realdengziqi/URGEPEAKLOGGER_AT32_-RTTHREAD/firmware/固件目录说明.md

# 固件目录说明

本目录存放参与固件构建的工程文件。

- `app`：应用入口和设备业务逻辑。
- `bsp/at32f403`：AT32F403ARGT7 板级支持和 RT-Thread 板级钩子。
- `cmake`：GCC/CMake 工具链文件和目标定义。
- `external_port`：第三方中间件的项目适配层。
- `linker`：GCC 链接脚本。
- `docs`：固件调试记录、硬件映射和设计说明。
- `vendor`：已复制到固件工程内并参与构建的第三方或厂商源码。

## 当前状态

- AT32F403A_407 官方固件库 V2.2.2 已从 `external` 复制到 `vendor`。
- 目标 MCU 已确认为 AT32F403ARGT7。
- RT-Thread 源码以 `external/rt-thread` 子模块形式跟踪，版本为 `v5.2.2`。
- RT-Thread v5.2.2 最小内核文件已复制到 `vendor/rt-thread-v5.2.2`，并已接入 GCC/CMake 构建。
- 当前硬件初始化覆盖已验证的调试串口、LED、按键、ST7789 SPI2 基础显示驱动、HDC1080 和 AT24C128C EEPROM。
- `drivers/sensor` 包含项目本地 HDC1080 I2C1 温湿度驱动。
- `drivers/storage` 包含项目本地 AT24C128C I2C2 EEPROM 驱动；参数持久化通过 FlashDB KVDB 使用这 16 KB EEPROM。
- `app_main` 当前处于后端优先模式。UI 自动初始化和 UI 按键轮询已暂停，使 COM12 串口测试优先聚焦后端数据访问。
- `app_data_service` 提供第一版后台数据服务线程和设备数据快照边界。当前线程名为 `data_svc`，优先级 18，栈 768 字节，更新周期 200 ms，并每 1000 ms 读取一次 HDC1080 环境温湿度。
- `app_param_service` 维护运行期参数表，执行范围校验，并通过 EEPROM KVDB 保存和加载参数镜像。
- `app_record_service` 提供运行期事件记录环形缓冲，当前容量 16 条，并将报警/普通事件与浪涌事件追加到片内 Flash TSDB。
- `app_ui` 保留为前端显示层，但在后端优先模式下不再自动启动。它只渲染 `data_service` 快照数据，不直接访问 ADC、Flash、Modbus 或硬件采样。
- `app_key_input` 扫描并消抖已验证的前面板按键，然后向 UI 层上报前端按键事件。
- `app_bringup` 封装 LED、按键和 LCD 的硬件 bring-up 命令，使 `app_main` 聚焦主循环和 CLI 分发。
- 当前主线只保留 GCC/CMake/J-Link CLI 构建和烧录路径。

## 调试文档

- `docs/硬件引脚映射.md`：已验证的调试串口、LED、按键和当前 ST7789 SPI2 屏幕路径 GPIO 映射。
- `docs/后端串口测试说明.md`：后端优先阶段的数据、参数、记录和 RTC 串口测试流程。
- `docs/命令行工具链迁移说明.md`：CMake/GCC/J-Link CLI 构建和烧录流程。
- `docs/后端数据架构规划.md`：数据后端、缓存、请求队列和 Modbus 响应及时性规划。
- `docs/罗氏线圈参数确认清单.md`：罗氏线圈参数、竞品信息和待确认项。
- `docs/罗氏线圈工作原理和测量方法.md`：罗氏线圈原理、高速 ADC 采样和数字积分测量路线。
- `docs/浪涌输入运放前端工作逻辑分析.md`：主控板浪涌输入运放前端拓扑和工作逻辑。
- `docs/调试命令说明.md`：当前 MSH/串口调试命令说明。
- `docs/图形界面集成计划.md`：uGUI/显示相关集成计划。
