realdengziqi/URGEPEAKLOGGER_AT32_-RTTHREAD/firmware/docs/后端数据架构规划.md

# 数据后端架构计划

本文记录当前后端优先开发方向。项目按工业仪表固件处理，UI、Modbus RTU、Modbus TCP、MSH 调试命令都属于前端；采样、参数、记录、报警和时间状态由后端服务统一维护。

## 分层边界

```text
硬件采集层
  ADC / NTC / HDC1080 / DI / RTC / RS485 / Ethernet / Flash-EEPROM
  ↓
后台服务层
  data_service / backend_request / param_service / record_service / alarm_service
  ↓
前端适配层
  UI / Modbus RTU / Modbus TCP / MSH / 后续 Web 配置
```

前端读取数据时只读 `data_service_get_snapshot()` 或专用查询接口；前端修改状态时提交 `backend_request`，不得直接写 Flash、记录区、报警状态或共享业务结构体。

非浪涌报警按 `非浪涌报警架构设计.md` 处理：活跃报警由 `alarm_service` 维护，计划用 EEPROM KVDB 保存未闭合报警恢复镜像；历史报警改为事件日志，`alarm_start` 和 `alarm_clear` 都由 `record_service` 追加写入片内 Flash TSDB，不在查询路径合并闭合记录。

## 线程计划

当前阶段保留少量线程，先把边界做稳：

| 线程 | 优先级 | 栈 | 职责 |
| --- | --- | --- | --- |
| `mb_rtu` | 16 | 1024 | FreeModbus RTU poll，只做协议收发和寄存器回调 |
| `backend_req` | 17 | 1536 | 串行处理前端写请求，例如设置参数、保存参数、清记录 |
| `data_svc` | 18 | 1024 | 维护统一数据快照，读取 RTC/低速传感器，融合参数状态和非浪涌报警状态 |
| `record_wr` | 20 | 1024 | 从消息队列消费记录持久化请求，异步追加 FlashDB TSDB |
| `tshell` | 20 | 2048 | 开发调试命令 |
| `main` | 10 | 2048 | 当前保留 bring-up poll，后续逐步减少业务职责 |

2026-06-23 串口实测线程状态：

| 线程 | 优先级 | 状态 | 栈使用 | 说明 |
| --- | --- | --- | --- | --- |
| `tshell` | 20 | `run` | 612/2048 | 正在执行 MSH 命令时为运行态，正常 |
| `mb_rtu` | 16 | `suspend` | 360/1024 | 等待 FreeModbus 事件，正常 |
| `backend_req` | 17 | `suspend` | 412/1024 | 等待前端请求队列，正常 |
| `record_wr` | 20 | `suspend` | 376/1024 | 等待记录写入队列，正常 |
| `data_svc` | 18 | `suspend` | 468/768 | 等待周期 tick，后续增加逻辑时建议改到 1024 |
| `tidle0` | 31 | `ready` | 104/512 | 空闲线程 |
| `timer` | 4 | `suspend` | 156/512 | RT-Thread 软件定时器线程 |
| `main` | 10 | `suspend` | 1100/2048 | 初始化完成后挂起，正常 |

后续接入高速采样、网络和 UI 后，再增加：

| 线程 | 建议优先级 | 职责 |
| --- | --- | --- |
| `adc_sample` | 12-14 | 采样调度、浪涌检测事件上报 |
| `modbus_tcp` | 16-17 | TCP 前端，共用 `modbus_map` |
| `ui` | 22 | LCD 页面刷新和按键事件消费 |

## 缓存机制

短期继续使用 `device_data_snapshot_t` 作为统一快照。快照由 `data_service` 写入，UI/Modbus/MSH 只读。

当前实现用短临界区复制快照，字段继续增加后建议切换到双缓冲：

```text
data_service 写 back buffer
更新 version/sequence
切换 active buffer
前端读取 active buffer
```

快照建议拆分语义，但对外可以继续合并输出：

```text
realtime      浪涌峰值、NTC、温湿度、DI
status        time_valid、sensor_valid、alarm、rs485、tcp
param_status  参数版本、dirty、持久化状态
diag          update_count、通信计数、错误计数
```

## 请求机制

`backend_request` 是前端写操作的统一入口。当前最小版本支持：

- 设置运行期参数
- 保存参数到 AT24C128 EEPROM KVDB
- 从 AT24C128 重新加载参数
- 恢复运行期默认参数
- 清除运行期记录

后续扩展：

- 设置 RTC 时间
- 清除报警
- 查询/删除历史记录
- 恢复出厂设置
- 网络参数变更后重启协议栈

原则：Modbus 回调和 UI 事件只提交请求并等待结果，不直接做持久化慢操作。

## Modbus 响应及时性规范

Modbus RTU 是强时序前端，寄存器回调必须尽快返回。后续所有 Modbus 相关开发遵守以下规则：

- Modbus 读寄存器只读取 RAM 快照、RAM 参数表或 RAM 状态计数，不允许触发 I2C、ADC 阻塞采样、EEPROM、Flash、网络重启等慢操作。
- Modbus 写普通运行参数只更新 RAM shadow，必须是有界快速操作。
- Modbus 写保存参数、清除记录、恢复默认、设置时间、网络重启等慢操作时，只投递异步请求并快速返回；实际完成状态通过状态寄存器查询。
- EEPROM/Flash 写入不得发生在 Modbus 回调路径内。
- 传感器采样不得发生在 Modbus 回调路径内；Modbus 只能读取 `data_service` 已缓存的快照。
- 如果某个操作最坏情况无法在数毫秒内完成，不得作为同步 Modbus 写回调执行。

当前代码约定：

- `backend_request_set_param_async()` / `backend_request_set_params_async()`：用于 Modbus 等强时序前端，只做参数校验和非阻塞入队；实际 RAM 参数更新由 `backend_req` 线程执行。
- `backend_request_*()` 同步接口：用于 MSH、UI 或显式慢操作请求；EEPROM/Flash 等慢操作仍不得发生在 Modbus 回调路径内。

## Modbus 映射

Modbus RTU 和后续 Modbus TCP 必须共用同一份寄存器映射。当前使用：

```text
app_modbus_rtu.c   协议线程、eMBInit/eMBPoll
app_modbus_map.c   holding/input/coils/discrete 映射
```

正式寄存器表冻结前，当前 holding/input 映射只作为 bring-up 和后端验证使用。

## 下一阶段验收

1. GCC/CMake 构建通过。
2. COM12 启动日志出现 `backend_req`、`data_svc`、`mb_rtu`。
3. MSH `param set/save/load/defaults` 通过 `backend_request` 正常工作。
4. COM16 Modbus 读 holding/input 正常，写 holding 参数后能读回。
5. `sys threads` 显示线程栈余量合理。
6. 记录追加不在 Modbus 回调路径内写 Flash，TSDB 写入由 `record_wr` 异步完成。
7. Modbus 并发读写和记录注入期间无 timeout，响应时间无明显长尾。

## 已确认硬件映射

- TI1..TI5 业务输入：底层对应 `DI0..DI4` / bit0..bit4，MCU 引脚为 `PA7 / PA6 / PA5 / PA4 / PA3`。业务默认 open 触发报警；当前已确认 open 为 MCU 低电平，close 为 MCU 高电平。
- PC0 / ADC1_IN10：NTC 输入，用户于 2026-06-22 确认。
- PC1 / ADC2_IN11：浪涌输入，用户于 2026-06-22 确认。
