realdengziqi/URGEPEAKLOGGER_AT32_-RTTHREAD/firmware/external_port/freemodbus_port/mbconfig.h

#ifndef MB_CONFIG_H
#define MB_CONFIG_H

#define MB_MASTER_ASCII_ENABLED                 (0)
#define MB_MASTER_RTU_ENABLED                   (0)
#define MB_MASTER_TCP_ENABLED                   (0)

#define MB_SLAVE_ASCII_ENABLED                  (0)
#define MB_SLAVE_RTU_ENABLED                    (1)
#define MB_SLAVE_TCP_ENABLED                    (0)

#define MB_ASCII_TIMEOUT_SEC                    (1)
#define MB_FUNC_HANDLERS_MAX                    (16)
#define MB_FUNC_OTHER_REP_SLAVEID_BUF           (32)
#define MB_FUNC_OTHER_REP_SLAVEID_ENABLED       (1)

#define MB_FUNC_READ_INPUT_ENABLED              (1)
#define MB_FUNC_READ_HOLDING_ENABLED            (1)
#define MB_FUNC_WRITE_HOLDING_ENABLED           (1)
#define MB_FUNC_WRITE_MULTIPLE_HOLDING_ENABLED  (1)
#define MB_FUNC_READ_COILS_ENABLED              (0)
#define MB_FUNC_WRITE_COIL_ENABLED              (0)
#define MB_FUNC_WRITE_MULTIPLE_COILS_ENABLED    (0)
#define MB_FUNC_READ_DISCRETE_INPUTS_ENABLED    (0)
#define MB_FUNC_READWRITE_HOLDING_ENABLED       (0)

#endif
