realdengziqi/URGEPEAKLOGGER_AT32_-RTTHREAD/firmware/bsp/at32f403/inc/rtconfig.h

#ifndef RT_CONFIG_H
#define RT_CONFIG_H

#define RT_NAME_MAX                     16
#define RT_ALIGN_SIZE                   4
#define RT_THREAD_PRIORITY_MAX          32
#define RT_TICK_PER_SECOND              1000
#define RT_CPUS_NR                      1

#define RT_USING_OVERFLOW_CHECK
#define RT_USING_HOOK

#define IDLE_THREAD_STACK_SIZE          512
#define RT_TIMER_THREAD_STACK_SIZE      512
#define RT_TIMER_THREAD_PRIO            4

#define RT_USING_TIMER_SOFT
#define RT_USING_SEMAPHORE
#define RT_USING_MUTEX
#define RT_USING_EVENT
#define RT_USING_MAILBOX
#define RT_USING_MESSAGEQUEUE

#define RT_USING_HEAP
#define RT_USING_SMALL_MEM
#define RT_USING_SMALL_MEM_AS_HEAP
#define RT_USING_CONSOLE
#define RT_CONSOLEBUF_SIZE              128
#define RT_BACKTRACE_LEVEL_MAX_NR       32

#define RT_USING_MSH
#define RT_USING_FINSH
#define FINSH_USING_MSH
#define FINSH_USING_SYMTAB
#define FINSH_USING_DESCRIPTION
#define FINSH_THREAD_NAME               "tshell"
#define FINSH_THREAD_PRIORITY           20
#define FINSH_THREAD_STACK_SIZE         2048
#define FINSH_CMD_SIZE                  96
#define FINSH_ARG_MAX                   8

#define RT_USING_USER_MAIN
#define RT_MAIN_THREAD_STACK_SIZE       2048
#define RT_MAIN_THREAD_PRIORITY         10

#endif
