realdengziqi/URGEPEAKLOGGER_AT32_-RTTHREAD/firmware/external_port/surge_ui_kit/surge_ui_widgets.c

#include "surge_ui_widgets.h"

#include "surge_ui_font_zh_18.h"
#include "surge_ui_font_zh_20.h"
#include "surge_ui_font_zh_24.h"
#include "ugui_port.h"

typedef struct
{
    rt_uint8_t width;
    rt_uint8_t height;
    rt_uint8_t bytes_per_row;
    rt_uint8_t bits_per_pixel;
    const surge_ui_zh_glyph_t *glyphs;
    rt_uint16_t glyph_count;
} surge_ui_zh_font_t;

static const surge_ui_zh_font_t surge_ui_zh_font_18 =
{
    SURGE_UI_ZH_18_FONT_W,
    SURGE_UI_ZH_18_FONT_H,
    SURGE_UI_ZH_18_FONT_BYTES_PER_ROW,
    SURGE_UI_ZH_18_FONT_BITS_PER_PIXEL,
    surge_ui_zh_18_glyphs,
    SURGE_UI_ZH_18_GLYPH_COUNT
};

static const surge_ui_zh_font_t surge_ui_zh_font_20 =
{
    SURGE_UI_ZH_20_FONT_W,
    SURGE_UI_ZH_20_FONT_H,
    SURGE_UI_ZH_20_FONT_BYTES_PER_ROW,
    SURGE_UI_ZH_20_FONT_BITS_PER_PIXEL,
    surge_ui_zh_20_glyphs,
    SURGE_UI_ZH_20_GLYPH_COUNT
};

static const surge_ui_zh_font_t surge_ui_zh_font_24 =
{
    SURGE_UI_ZH_24_FONT_W,
    SURGE_UI_ZH_24_FONT_H,
    SURGE_UI_ZH_24_FONT_BYTES_PER_ROW,
    SURGE_UI_ZH_24_FONT_BITS_PER_PIXEL,
    surge_ui_zh_24_glyphs,
    SURGE_UI_ZH_24_GLYPH_COUNT
};

static const surge_ui_text_style_t surge_ui_default_text_8 =
{
    SURGE_UI_ZH_SIZE_18,
    &FONT_8X12
};

#if SURGE_UI_USE_HEADER
static const surge_ui_header_style_t surge_ui_default_header_style =
{
    { SURGE_UI_ZH_SIZE_18, &FONT_12X20 },
    { SURGE_UI_ZH_SIZE_18, &FONT_8X12 },
    8,
    7,
    182,
    10
};
#endif

#if SURGE_UI_USE_NAV_HEADER
static const surge_ui_nav_header_style_t surge_ui_default_nav_header_style =
{
    { SURGE_UI_ZH_SIZE_18, &FONT_8X12 },
    { SURGE_UI_ZH_SIZE_18, &FONT_12X20 },
    { SURGE_UI_ZH_SIZE_18, &FONT_8X12 },
    8,
    10,
    48,
    7,
    182,
    10
};
#endif

#if SURGE_UI_USE_FOOTER
static const surge_ui_footer_style_t surge_ui_default_footer_style =
{
    { SURGE_UI_ZH_SIZE_18, &FONT_8X12 },
    8,
    226
};
#endif

#if SURGE_UI_USE_SECTION_TITLE
static const surge_ui_section_title_style_t surge_ui_default_section_title_style =
{
    { SURGE_UI_ZH_SIZE_18, &FONT_8X12 },
    22,
    4,
    14,
    4,
    12,
    4,
    8,
    13
};
#endif

#if SURGE_UI_USE_EMPTY_STATE
static const surge_ui_empty_state_style_t surge_ui_default_empty_state_style =
{
    { SURGE_UI_ZH_SIZE_20, &FONT_12X20 },
    { SURGE_UI_ZH_SIZE_18, &FONT_8X12 },
    96,
    24,
    5,
    44,
    72
};
#endif

#if SURGE_UI_USE_LOADING_STATE
static const surge_ui_loading_state_style_t surge_ui_default_loading_state_style =
{
    { SURGE_UI_ZH_SIZE_20, &FONT_12X20 },
    { SURGE_UI_ZH_SIZE_18, &FONT_8X12 },
    96,
    25,
    4,
    14,
    44,
    72
};
#endif

#if SURGE_UI_USE_TOAST
static const surge_ui_toast_style_t surge_ui_default_toast_style =
{
    { SURGE_UI_ZH_SIZE_18, &FONT_10X16 },
    34,
    8,
    5
};
#endif

#if SURGE_UI_USE_PAGE_INDICATOR
static const surge_ui_page_indicator_style_t surge_ui_default_page_indicator_style =
{
    18,
    8,
    3,
    8
};
#endif

#if SURGE_UI_USE_ACTION_BAR
static const surge_ui_action_bar_style_t surge_ui_default_action_bar_style =
{
    { SURGE_UI_ZH_SIZE_18, &FONT_10X16 },
    34,
    0,
    10,
    8
};
#endif

#if SURGE_UI_USE_SAVE_STATUS_CHIP
static const surge_ui_save_status_chip_style_t surge_ui_default_save_status_chip_style =
{
    { SURGE_UI_ZH_SIZE_18, &FONT_8X12 },
    22,
    8,
    10,
    11,
    3,
    5
};
#endif

#if SURGE_UI_USE_COMPACT_VALUE_TILE
static const surge_ui_compact_value_tile_style_t surge_ui_default_compact_value_tile_style =
{
    { SURGE_UI_ZH_SIZE_18, &FONT_8X12 },
    { SURGE_UI_ZH_SIZE_18, &FONT_10X16 },
    { SURGE_UI_ZH_SIZE_18, &FONT_8X12 },
    56,
    6,
    25,
    42,
    2,
    3
};
#endif

#if SURGE_UI_USE_COMPACT_STATUS_TILE
static const surge_ui_compact_status_tile_style_t surge_ui_default_compact_status_tile_style =
{
    { SURGE_UI_ZH_SIZE_18, &FONT_8X12 },
    { SURGE_UI_ZH_SIZE_18, &FONT_12X20 },
    54,
    7,
    28,
    2
};
#endif

#if SURGE_UI_USE_SWITCH
static const surge_ui_switch_style_t surge_ui_default_switch_style =
{
    { SURGE_UI_ZH_SIZE_18, &FONT_10X16 },
    32,
    8
};
#endif

#if SURGE_UI_USE_STEPPER
static const surge_ui_stepper_style_t surge_ui_default_stepper_style =
{
    { SURGE_UI_ZH_SIZE_18, &FONT_8X12 },
    { SURGE_UI_ZH_SIZE_18, &FONT_10X16 },
    { SURGE_UI_ZH_SIZE_18, &FONT_8X12 },
    { SURGE_UI_ZH_SIZE_18, &FONT_10X16 },
    46,
    10,
    7,
    20,
    22,
    26,
    24,
    11,
    62,
    4
};
#endif

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
};
#endif

#if SURGE_UI_USE_DETAIL_VALUE
static const surge_ui_detail_value_style_t surge_ui_default_detail_value_style =
{
    { SURGE_UI_ZH_SIZE_18, &FONT_10X16 },
    { SURGE_UI_ZH_SIZE_18, &FONT_16X26 },
    { SURGE_UI_ZH_SIZE_18, &FONT_10X16 },
    82,
    10,
    36,
    44,
    6
};
#endif

#if SURGE_UI_USE_DETAIL_FIELD_ROW
static const surge_ui_detail_field_row_style_t surge_ui_default_detail_field_row_style =
{
    { SURGE_UI_ZH_SIZE_18, &FONT_8X12 },
    { SURGE_UI_ZH_SIZE_18, &FONT_8X12 },
    28,
    10,
    8,
    10,
    8
};
#endif

#if SURGE_UI_USE_CONFIRM_DIALOG
static const surge_ui_confirm_dialog_style_t surge_ui_default_confirm_dialog_style =
{
    { SURGE_UI_ZH_SIZE_20, &FONT_12X20 },
    { SURGE_UI_ZH_SIZE_18, &FONT_10X16 },
    { SURGE_UI_ZH_SIZE_18, &FONT_10X16 },
    118,
    14,
    48,
    78,
    12,
    30,
    16
};
#endif

static UG_COLOR surge_ui_status_color(surge_ui_status_t status)
{
    if (status == SURGE_UI_STATUS_ALARM)
    {
        return SURGE_UI_COLOR_ALARM;
    }

    if (status == SURGE_UI_STATUS_WARN)
    {
        return SURGE_UI_COLOR_WARN;
    }

    return SURGE_UI_COLOR_OK;
}

#if SURGE_UI_USE_ACTION_BAR || SURGE_UI_USE_CONFIRM_DIALOG
static UG_COLOR surge_ui_status_text_color(surge_ui_status_t status)
{
    if (status == SURGE_UI_STATUS_ALARM)
    {
        return SURGE_UI_COLOR_TEXT;
    }

    return SURGE_UI_COLOR_BG;
}
#endif

static const rt_uint8_t *surge_ui_find_zh_glyph(const surge_ui_zh_font_t *zh_font, rt_uint16_t codepoint)
{
    rt_uint16_t i;

    for (i = 0U; i < zh_font->glyph_count; i++)
    {
        if (zh_font->glyphs[i].codepoint == codepoint)
        {
            return zh_font->glyphs[i].bitmap;
        }
    }

    return RT_NULL;
}

static const surge_ui_zh_font_t *surge_ui_get_zh_font(surge_ui_zh_size_t size)
{
    if (size == SURGE_UI_ZH_SIZE_24)
    {
        return &surge_ui_zh_font_24;
    }

    if (size == SURGE_UI_ZH_SIZE_20)
    {
        return &surge_ui_zh_font_20;
    }

    return &surge_ui_zh_font_18;
}

#if SURGE_UI_USE_SECTION_TITLE || SURGE_UI_USE_EMPTY_STATE || SURGE_UI_USE_LOADING_STATE || SURGE_UI_USE_TOAST || SURGE_UI_USE_ACTION_BAR || SURGE_UI_USE_SAVE_STATUS_CHIP || SURGE_UI_USE_COMPACT_VALUE_TILE || SURGE_UI_USE_COMPACT_STATUS_TILE || SURGE_UI_USE_SWITCH || SURGE_UI_USE_STEPPER || SURGE_UI_USE_RECORD_ROW || SURGE_UI_USE_DETAIL_VALUE || SURGE_UI_USE_DETAIL_FIELD_ROW || SURGE_UI_USE_CONFIRM_DIALOG
static rt_int16_t surge_ui_text_width(const char *text, const surge_ui_text_style_t *style)
{
    const surge_ui_text_style_t *resolved;
    const surge_ui_zh_font_t *zh_font;
    const UG_FONT *ascii_font;
    const unsigned char *p;
    rt_int16_t width;

    if (text == RT_NULL)
    {
        return 0;
    }

    resolved = (style != RT_NULL) ? style : &surge_ui_default_text_8;
    zh_font = surge_ui_get_zh_font(resolved->zh_size);
    ascii_font = (resolved->ascii_font != RT_NULL) ? resolved->ascii_font : &FONT_8X12;
    p = (const unsigned char *)text;
    width = 0;

    while (*p != '\0')
    {
        if (*p < 0x80U)
        {
            width = (rt_int16_t)(width + ascii_font->char_width);
            p++;
            continue;
        }

        if (((p[0] & 0xF0U) == 0xE0U) && ((p[1] & 0xC0U) == 0x80U) && ((p[2] & 0xC0U) == 0x80U))
        {
            width = (rt_int16_t)(width + zh_font->width);
            p = (const unsigned char *)(p + 3);
        }
        else
        {
            width = (rt_int16_t)(width + zh_font->width);
            p++;
        }
    }

    return width;
}
#endif

#if SURGE_UI_USE_EMPTY_STATE || SURGE_UI_USE_LOADING_STATE || SURGE_UI_USE_TOAST || SURGE_UI_USE_ACTION_BAR || SURGE_UI_USE_SAVE_STATUS_CHIP || SURGE_UI_USE_COMPACT_VALUE_TILE || SURGE_UI_USE_COMPACT_STATUS_TILE || SURGE_UI_USE_SWITCH || SURGE_UI_USE_STEPPER || SURGE_UI_USE_DETAIL_VALUE || SURGE_UI_USE_CONFIRM_DIALOG
static void surge_ui_draw_centered_text(rt_int16_t x,
                                        rt_int16_t y,
                                        rt_int16_t w,
                                        const char *text,
                                        UG_COLOR fg,
                                        UG_COLOR bg,
                                        const surge_ui_text_style_t *style)
{
    rt_int16_t text_w;
    rt_int16_t text_x;

    text_w = surge_ui_text_width(text, style);
    text_x = x;
    if (text_w < w)
    {
        text_x = (rt_int16_t)(x + ((w - text_w) / 2));
    }

    surge_ui_draw_text(text_x, y, text, fg, bg, style);
}
#endif

static UG_COLOR surge_ui_blend_rgb565(UG_COLOR fg, UG_COLOR bg, rt_uint8_t level)
{
    rt_uint16_t fr;
    rt_uint16_t fg6;
    rt_uint16_t fb;
    rt_uint16_t br;
    rt_uint16_t bg6;
    rt_uint16_t bb;
    rt_uint16_t r;
    rt_uint16_t g;
    rt_uint16_t b;

    if (level == 0U)
    {
        return bg;
    }
    if (level >= 15U)
    {
        return fg;
    }

    fr = (rt_uint16_t)((fg >> 11) & 0x1FU);
    fg6 = (rt_uint16_t)((fg >> 5) & 0x3FU);
    fb = (rt_uint16_t)(fg & 0x1FU);
    br = (rt_uint16_t)((bg >> 11) & 0x1FU);
    bg6 = (rt_uint16_t)((bg >> 5) & 0x3FU);
    bb = (rt_uint16_t)(bg & 0x1FU);

    r = (rt_uint16_t)(((fr * level) + (br * (15U - level)) + 7U) / 15U);
    g = (rt_uint16_t)(((fg6 * level) + (bg6 * (15U - level)) + 7U) / 15U);
    b = (rt_uint16_t)(((fb * level) + (bb * (15U - level)) + 7U) / 15U);

    return (UG_COLOR)((r << 11) | (g << 5) | b);
}

static void surge_ui_draw_zh_glyph(rt_int16_t x,
                                   rt_int16_t y,
                                   const surge_ui_zh_font_t *zh_font,
                                   const rt_uint8_t *bitmap,
                                   UG_COLOR fg,
                                   UG_COLOR bg)
{
    rt_uint8_t row;

    for (row = 0U; row < zh_font->height; row++)
    {
        rt_uint8_t col;
        for (col = 0U; col < zh_font->width; col++)
        {
            rt_uint8_t byte_value;
            rt_uint8_t byte_index;
            rt_uint8_t shift;
            rt_uint8_t level;

            byte_index = (rt_uint8_t)((row * zh_font->bytes_per_row) + (col / 2U));
            shift = (rt_uint8_t)(4U - ((col % 2U) * 4U));
            byte_value = bitmap[byte_index];
            level = (rt_uint8_t)((byte_value >> shift) & 0x0FU);
            UG_DrawPixel((UG_S16)(x + col), (UG_S16)(y + row), surge_ui_blend_rgb565(fg, bg, level));
        }
    }
}

static void surge_ui_put_string_base(rt_int16_t x,
                                     rt_int16_t y,
                                     const char *text,
                                     UG_COLOR fg,
                                     UG_COLOR bg,
                                     const UG_FONT *font,
                                     const surge_ui_zh_font_t *zh_font)
{
    const unsigned char *p;
    rt_int16_t cursor_x;
    char ascii[2];

    if ((text == RT_NULL) || (font == RT_NULL) || (zh_font == RT_NULL))
    {
        return;
    }

    p = (const unsigned char *)text;
    cursor_x = x;
    ascii[1] = '\0';

    while (*p != '\0')
    {
        rt_uint16_t codepoint;
        const rt_uint8_t *bitmap;

        if (*p < 0x80U)
        {
            ascii[0] = (char)*p;
            UG_FontSelect(font);
            UG_SetForecolor(fg);
            UG_SetBackcolor(bg);
            UG_PutString(cursor_x, y, ascii);
            cursor_x = (rt_int16_t)(cursor_x + font->char_width);
            p++;
            continue;
        }

        codepoint = 0U;
        if (((p[0] & 0xF0U) == 0xE0U) && ((p[1] & 0xC0U) == 0x80U) && ((p[2] & 0xC0U) == 0x80U))
        {
            codepoint = (rt_uint16_t)(((p[0] & 0x0FU) << 12) | ((p[1] & 0x3FU) << 6) | (p[2] & 0x3FU));
            p = (const unsigned char *)(p + 3);
        }
        else
        {
            p++;
            cursor_x = (rt_int16_t)(cursor_x + zh_font->width);
            continue;
        }

        bitmap = surge_ui_find_zh_glyph(zh_font, codepoint);
        if (bitmap != RT_NULL)
        {
            surge_ui_draw_zh_glyph(cursor_x, y, zh_font, bitmap, fg, bg);
        }
        else
        {
            UG_FillFrame(cursor_x, y, (UG_S16)(cursor_x + zh_font->width - 1), (UG_S16)(y + zh_font->height - 1), bg);
        }

        cursor_x = (rt_int16_t)(cursor_x + zh_font->width);
    }
}

void surge_ui_draw_text_18(rt_int16_t x,
                           rt_int16_t y,
                           const char *text,
                           UG_COLOR fg,
                           UG_COLOR bg,
                           const UG_FONT *ascii_font)
{
    surge_ui_put_string_base(x, y, text, fg, bg, ascii_font, &surge_ui_zh_font_18);
}

void surge_ui_draw_text_20(rt_int16_t x,
                           rt_int16_t y,
                           const char *text,
                           UG_COLOR fg,
                           UG_COLOR bg,
                           const UG_FONT *ascii_font)
{
    surge_ui_put_string_base(x, y, text, fg, bg, ascii_font, &surge_ui_zh_font_20);
}

void surge_ui_draw_text_24(rt_int16_t x,
                           rt_int16_t y,
                           const char *text,
                           UG_COLOR fg,
                           UG_COLOR bg,
                           const UG_FONT *ascii_font)
{
    surge_ui_put_string_base(x, y, text, fg, bg, ascii_font, &surge_ui_zh_font_24);
}

void surge_ui_draw_text(rt_int16_t x,
                        rt_int16_t y,
                        const char *text,
                        UG_COLOR fg,
                        UG_COLOR bg,
                        const surge_ui_text_style_t *style)
{
    const surge_ui_text_style_t *resolved;
    const UG_FONT *ascii_font;

    resolved = (style != RT_NULL) ? style : &surge_ui_default_text_8;
    ascii_font = (resolved->ascii_font != RT_NULL) ? resolved->ascii_font : &FONT_8X12;

    if (resolved->zh_size == SURGE_UI_ZH_SIZE_24)
    {
        surge_ui_draw_text_24(x, y, text, fg, bg, ascii_font);
    }
    else if (resolved->zh_size == SURGE_UI_ZH_SIZE_20)
    {
        surge_ui_draw_text_20(x, y, text, fg, bg, ascii_font);
    }
    else
    {
        surge_ui_draw_text_18(x, y, text, fg, bg, ascii_font);
    }
}

void surge_ui_begin(void)
{
    ugui_port_init();
    ugui_port_clear(SURGE_UI_COLOR_BG);
}

#if SURGE_UI_USE_HEADER
void surge_ui_draw_header(const char *title,
                          const char *right_text,
                          const surge_ui_header_style_t *style)
{
    UG_FillFrame(0, 0, 239, 31, SURGE_UI_COLOR_HEADER);
    UG_FillFrame(0, 31, 239, 32, SURGE_UI_COLOR_ACCENT);
    if (style == RT_NULL)
    {
        style = &surge_ui_default_header_style;
    }
    surge_ui_draw_text(style->title_x, style->title_y, title, SURGE_UI_COLOR_TEXT, SURGE_UI_COLOR_HEADER, &style->title_text);
    surge_ui_draw_text(style->right_x, style->right_y, right_text, SURGE_UI_COLOR_MUTED, SURGE_UI_COLOR_HEADER, &style->right_text);
}
#endif

#if SURGE_UI_USE_NAV_HEADER
void surge_ui_draw_nav_header(const char *title,
                              const char *right_text,
                              const char *back_text,
                              const surge_ui_nav_header_style_t *style)
{
    if (style == RT_NULL)
    {
        style = &surge_ui_default_nav_header_style;
    }

    if (back_text == RT_NULL)
    {
        back_text = "<";
    }

    UG_FillFrame(0, 0, 239, 31, SURGE_UI_COLOR_HEADER);
    UG_FillFrame(0, 31, 239, 32, SURGE_UI_COLOR_ACCENT);
    surge_ui_draw_text(style->back_x, style->back_y, back_text, SURGE_UI_COLOR_ACCENT, SURGE_UI_COLOR_HEADER, &style->back_text);
    surge_ui_draw_text(style->title_x, style->title_y, title, SURGE_UI_COLOR_TEXT, SURGE_UI_COLOR_HEADER, &style->title_text);
    surge_ui_draw_text(style->right_x, style->right_y, right_text, SURGE_UI_COLOR_MUTED, SURGE_UI_COLOR_HEADER, &style->right_text);
}
#endif

#if SURGE_UI_USE_FOOTER
void surge_ui_draw_footer(const char *text, const surge_ui_footer_style_t *style)
{
    UG_FillFrame(0, 222, 239, 239, SURGE_UI_COLOR_SURFACE);
    if (style == RT_NULL)
    {
        style = &surge_ui_default_footer_style;
    }
    surge_ui_draw_text(style->text_x, style->text_y, text, SURGE_UI_COLOR_MUTED, SURGE_UI_COLOR_SURFACE, &style->text);
}
#endif

#if SURGE_UI_USE_SECTION_TITLE
void surge_ui_draw_section_title(rt_int16_t x,
                                 rt_int16_t y,
                                 rt_int16_t w,
                                 const char *title,
                                 surge_ui_status_t status,
                                 const surge_ui_section_title_style_t *style)
{
    UG_COLOR accent;
    rt_int16_t height;
    rt_int16_t marker_w;
    rt_int16_t marker_h;
    rt_int16_t title_w;
    rt_int16_t line_x;
    rt_int16_t line_y;

    if (w < 32)
    {
        return;
    }

    if (style == RT_NULL)
    {
        style = &surge_ui_default_section_title_style;
    }

    height = style->height;
    if (height < 16)
    {
        height = surge_ui_default_section_title_style.height;
    }

    marker_w = style->marker_w;
    if (marker_w < 1)
    {
        marker_w = 1;
    }

    marker_h = style->marker_h;
    if (marker_h < 4)
    {
        marker_h = 4;
    }

    accent = surge_ui_status_color(status);
    title_w = surge_ui_text_width(title, &style->text);
    line_x = (rt_int16_t)(x + style->text_x + title_w + style->line_gap);
    line_y = (rt_int16_t)(y + style->line_y);

    UG_FillFrame(x, y, (UG_S16)(x + w - 1), (UG_S16)(y + height - 1), SURGE_UI_COLOR_BG);
    UG_FillFrame(x,
                 (rt_int16_t)(y + style->marker_y),
                 (UG_S16)(x + marker_w - 1),
                 (UG_S16)(y + style->marker_y + marker_h - 1),
                 accent);
    surge_ui_draw_text((rt_int16_t)(x + style->text_x),
                       (rt_int16_t)(y + style->text_y),
                       title,
                       SURGE_UI_COLOR_TEXT,
                       SURGE_UI_COLOR_BG,
                       &style->text);

    if (line_x < (rt_int16_t)(x + w - 2))
    {
        UG_DrawLine(line_x, line_y, (UG_S16)(x + w - 1), line_y, SURGE_UI_COLOR_LINE);
    }
}
#endif

#if SURGE_UI_USE_EMPTY_STATE
void surge_ui_draw_empty_state(rt_int16_t x,
                               rt_int16_t y,
                               rt_int16_t w,
                               rt_int16_t h,
                               const char *title,
                               const char *message,
                               surge_ui_status_t status,
                               const surge_ui_empty_state_style_t *style)
{
    UG_COLOR accent;
    rt_int16_t height;
    rt_int16_t icon_radius;
    rt_int16_t icon_x;
    rt_int16_t icon_y;

    if (w < 80 || h < 64)
    {
        return;
    }

    if (style == RT_NULL)
    {
        style = &surge_ui_default_empty_state_style;
    }

    height = h;
    if (height < style->min_height)
    {
        height = style->min_height;
    }

    icon_radius = style->icon_radius;
    if (icon_radius < 2)
    {
        icon_radius = 2;
    }

    accent = surge_ui_status_color(status);
    icon_x = (rt_int16_t)(x + (w / 2));
    icon_y = (rt_int16_t)(y + style->icon_y);

    UG_FillRoundFrame(x, y, (UG_S16)(x + w - 1), (UG_S16)(y + height - 1), 5, SURGE_UI_COLOR_SURFACE);
    UG_DrawRoundFrame(x, y, (UG_S16)(x + w - 1), (UG_S16)(y + height - 1), 5, SURGE_UI_COLOR_LINE);
    UG_FillCircle(icon_x, icon_y, icon_radius, accent);
    if (icon_radius > 3)
    {
        UG_FillCircle(icon_x, icon_y, (UG_S16)(icon_radius - 3), SURGE_UI_COLOR_SURFACE);
    }

    surge_ui_draw_centered_text(x,
                                (rt_int16_t)(y + style->title_y),
                                w,
                                title,
                                SURGE_UI_COLOR_TEXT,
                                SURGE_UI_COLOR_SURFACE,
                                &style->title_text);
    surge_ui_draw_centered_text(x,
                                (rt_int16_t)(y + style->message_y),
                                w,
                                message,
                                SURGE_UI_COLOR_MUTED,
                                SURGE_UI_COLOR_SURFACE,
                                &style->message_text);
}
#endif

#if SURGE_UI_USE_LOADING_STATE
void surge_ui_draw_loading_state(rt_int16_t x,
                                 rt_int16_t y,
                                 rt_int16_t w,
                                 rt_int16_t h,
                                 const char *title,
                                 const char *message,
                                 rt_uint8_t step,
                                 surge_ui_status_t status,
                                 const surge_ui_loading_state_style_t *style)
{
    UG_COLOR accent;
    rt_int16_t height;
    rt_int16_t dot_radius;
    rt_int16_t dot_gap;
    rt_int16_t dot_y;
    rt_int16_t start_x;
    rt_uint8_t i;
    rt_uint8_t active;

    if (w < 80 || h < 64)
    {
        return;
    }

    if (style == RT_NULL)
    {
        style = &surge_ui_default_loading_state_style;
    }

    height = h;
    if (height < style->min_height)
    {
        height = style->min_height;
    }

    dot_radius = style->dot_radius;
    if (dot_radius < 2)
    {
        dot_radius = 2;
    }

    dot_gap = style->dot_gap;
    if (dot_gap < (rt_int16_t)(dot_radius * 2 + 2))
    {
        dot_gap = (rt_int16_t)(dot_radius * 2 + 2);
    }

    accent = surge_ui_status_color(status);
    active = (rt_uint8_t)(step % 4U);
    dot_y = (rt_int16_t)(y + style->dots_y);
    start_x = (rt_int16_t)(x + (w / 2) - ((dot_gap * 3) / 2));

    UG_FillRoundFrame(x, y, (UG_S16)(x + w - 1), (UG_S16)(y + height - 1), 5, SURGE_UI_COLOR_SURFACE);
    UG_DrawRoundFrame(x, y, (UG_S16)(x + w - 1), (UG_S16)(y + height - 1), 5, SURGE_UI_COLOR_LINE);

    for (i = 0U; i < 4U; i++)
    {
        UG_COLOR dot_color = (i == active) ? accent : SURGE_UI_COLOR_LINE;
        UG_FillCircle((rt_int16_t)(start_x + (dot_gap * i)), dot_y, dot_radius, dot_color);
    }

    surge_ui_draw_centered_text(x,
                                (rt_int16_t)(y + style->title_y),
                                w,
                                title,
                                SURGE_UI_COLOR_TEXT,
                                SURGE_UI_COLOR_SURFACE,
                                &style->title_text);
    surge_ui_draw_centered_text(x,
                                (rt_int16_t)(y + style->message_y),
                                w,
                                message,
                                SURGE_UI_COLOR_MUTED,
                                SURGE_UI_COLOR_SURFACE,
                                &style->message_text);
}
#endif

#if SURGE_UI_USE_TOAST
void surge_ui_draw_toast(rt_int16_t x,
                         rt_int16_t y,
                         rt_int16_t w,
                         const char *text,
                         surge_ui_status_t status,
                         const surge_ui_toast_style_t *style)
{
    UG_COLOR accent;
    rt_int16_t height;
    rt_int16_t accent_w;

    if (w < 56)
    {
        return;
    }

    if (style == RT_NULL)
    {
        style = &surge_ui_default_toast_style;
    }

    height = style->height;
    if (height < 22)
    {
        height = surge_ui_default_toast_style.height;
    }

    accent_w = style->accent_w;
    if (accent_w < 2)
    {
        accent_w = 2;
    }

    accent = surge_ui_status_color(status);

    UG_FillRoundFrame((rt_int16_t)(x + 2),
                      (rt_int16_t)(y + 3),
                      (UG_S16)(x + w + 1),
                      (UG_S16)(y + height + 2),
                      5,
                      SURGE_UI_COLOR_HEADER);
    UG_FillRoundFrame(x, y, (UG_S16)(x + w - 1), (UG_S16)(y + height - 1), 5, SURGE_UI_COLOR_SURFACE_ALT);
    UG_DrawRoundFrame(x, y, (UG_S16)(x + w - 1), (UG_S16)(y + height - 1), 5, accent);
    UG_FillFrame((rt_int16_t)(x + 1),
                 (rt_int16_t)(y + 5),
                 (UG_S16)(x + accent_w),
                 (UG_S16)(y + height - 6),
                 accent);
    surge_ui_draw_centered_text(x,
                                (rt_int16_t)(y + style->text_y),
                                w,
                                text,
                                SURGE_UI_COLOR_TEXT,
                                SURGE_UI_COLOR_SURFACE_ALT,
                                &style->text);
}
#endif

#if SURGE_UI_USE_PAGE_INDICATOR
void surge_ui_draw_page_indicator(rt_int16_t x,
                                  rt_int16_t y,
                                  rt_int16_t w,
                                  rt_uint8_t current_page,
                                  rt_uint8_t page_count,
                                  const surge_ui_page_indicator_style_t *style)
{
    rt_int16_t height;
    rt_int16_t dot_radius;
    rt_int16_t dot_gap;
    rt_int16_t dot_step;
    rt_int16_t total_w;
    rt_int16_t start_x;
    rt_int16_t dot_y;
    rt_uint8_t i;

    if (w < 24 || page_count == 0U)
    {
        return;
    }

    if (style == RT_NULL)
    {
        style = &surge_ui_default_page_indicator_style;
    }

    if (current_page < 1U)
    {
        current_page = 1U;
    }
    if (current_page > page_count)
    {
        current_page = page_count;
    }

    height = style->height;
    if (height < 8)
    {
        height = surge_ui_default_page_indicator_style.height;
    }

    dot_radius = style->dot_radius;
    if (dot_radius < 1)
    {
        dot_radius = 1;
    }

    dot_gap = style->dot_gap;
    if (dot_gap < 2)
    {
        dot_gap = 2;
    }

    dot_step = (rt_int16_t)((dot_radius * 2) + dot_gap);
    total_w = (rt_int16_t)((page_count * dot_radius * 2) + ((page_count - 1U) * dot_gap));
    while (total_w > w && dot_gap > 2)
    {
        dot_gap--;
        dot_step = (rt_int16_t)((dot_radius * 2) + dot_gap);
        total_w = (rt_int16_t)((page_count * dot_radius * 2) + ((page_count - 1U) * dot_gap));
    }

    if (total_w > w)
    {
        return;
    }

    start_x = (rt_int16_t)(x + ((w - total_w) / 2) + dot_radius);
    dot_y = (rt_int16_t)(y + style->dot_y);

    UG_FillFrame(x, y, (UG_S16)(x + w - 1), (UG_S16)(y + height - 1), SURGE_UI_COLOR_BG);

    for (i = 0U; i < page_count; i++)
    {
        UG_COLOR color = ((rt_uint8_t)(i + 1U) == current_page) ? SURGE_UI_COLOR_ACCENT : SURGE_UI_COLOR_LINE;
        UG_FillCircle((rt_int16_t)(start_x + (i * dot_step)), dot_y, dot_radius, color);
    }
}
#endif

#if SURGE_UI_USE_LIST_VIEW
static rt_uint8_t surge_ui_list_resolve_visible_count(rt_uint8_t visible_count)
{
    return visible_count == 0U ? 1U : visible_count;
}

static rt_uint8_t surge_ui_list_max_top(rt_uint8_t item_count, rt_uint8_t visible_count)
{
    rt_uint8_t resolved_visible = surge_ui_list_resolve_visible_count(visible_count);
    if (item_count <= resolved_visible)
    {
        return 0U;
    }

    return (rt_uint8_t)(item_count - resolved_visible);
}

void surge_ui_list_ensure_visible(surge_ui_list_state_t *state)
{
    rt_uint8_t max_top;

    if (state == RT_NULL)
    {
        return;
    }

    state->visible_count = surge_ui_list_resolve_visible_count(state->visible_count);
    if (state->item_count == 0U)
    {
        state->selected_index = 0U;
        state->top_index = 0U;
        return;
    }

    if (state->selected_index >= state->item_count)
    {
        state->selected_index = (rt_uint8_t)(state->item_count - 1U);
    }

    max_top = surge_ui_list_max_top(state->item_count, state->visible_count);
    if (state->top_index > max_top)
    {
        state->top_index = max_top;
    }

    if (state->selected_index < state->top_index)
    {
        state->top_index = state->selected_index;
    }
    else if (state->selected_index >= (rt_uint8_t)(state->top_index + state->visible_count))
    {
        state->top_index = (rt_uint8_t)(state->selected_index - state->visible_count + 1U);
    }

    if (state->top_index > max_top)
    {
        state->top_index = max_top;
    }
}

void surge_ui_list_init(surge_ui_list_state_t *state,
                        rt_uint8_t item_count,
                        rt_uint8_t visible_count)
{
    if (state == RT_NULL)
    {
        return;
    }

    state->item_count = item_count;
    state->visible_count = surge_ui_list_resolve_visible_count(visible_count);
    state->selected_index = 0U;
    state->top_index = 0U;
    surge_ui_list_ensure_visible(state);
}

void surge_ui_list_set_item_count(surge_ui_list_state_t *state, rt_uint8_t item_count)
{
    if (state == RT_NULL)
    {
        return;
    }

    state->item_count = item_count;
    surge_ui_list_ensure_visible(state);
}

void surge_ui_list_set_visible_count(surge_ui_list_state_t *state, rt_uint8_t visible_count)
{
    if (state == RT_NULL)
    {
        return;
    }

    state->visible_count = surge_ui_list_resolve_visible_count(visible_count);
    surge_ui_list_ensure_visible(state);
}

void surge_ui_list_set_selected(surge_ui_list_state_t *state, rt_uint8_t selected_index)
{
    if (state == RT_NULL)
    {
        return;
    }

    state->selected_index = selected_index;
    surge_ui_list_ensure_visible(state);
}

void surge_ui_list_move(surge_ui_list_state_t *state, surge_ui_list_move_t move)
{
    rt_uint8_t step;

    if (state == RT_NULL)
    {
        return;
    }

    state->visible_count = surge_ui_list_resolve_visible_count(state->visible_count);
    if (state->item_count == 0U)
    {
        surge_ui_list_ensure_visible(state);
        return;
    }

    step = state->visible_count;
    if (move == SURGE_UI_LIST_MOVE_PREV)
    {
        if (state->selected_index > 0U)
        {
            state->selected_index--;
        }
    }
    else if (move == SURGE_UI_LIST_MOVE_NEXT)
    {
        if (state->selected_index < (rt_uint8_t)(state->item_count - 1U))
        {
            state->selected_index++;
        }
    }
    else if (move == SURGE_UI_LIST_MOVE_PAGE_PREV)
    {
        if (state->selected_index > step)
        {
            state->selected_index = (rt_uint8_t)(state->selected_index - step);
        }
        else
        {
            state->selected_index = 0U;
        }
    }
    else if (move == SURGE_UI_LIST_MOVE_PAGE_NEXT)
    {
        rt_uint8_t max_index = (rt_uint8_t)(state->item_count - 1U);
        if ((rt_uint16_t)(state->selected_index + step) < state->item_count)
        {
            state->selected_index = (rt_uint8_t)(state->selected_index + step);
        }
        else
        {
            state->selected_index = max_index;
        }
    }
    else if (move == SURGE_UI_LIST_MOVE_FIRST)
    {
        state->selected_index = 0U;
    }
    else if (move == SURGE_UI_LIST_MOVE_LAST)
    {
        state->selected_index = (rt_uint8_t)(state->item_count - 1U);
    }

    surge_ui_list_ensure_visible(state);
}

rt_uint8_t surge_ui_list_page_count(const surge_ui_list_state_t *state)
{
    rt_uint8_t visible_count;

    if ((state == RT_NULL) || (state->item_count == 0U))
    {
        return 0U;
    }

    visible_count = surge_ui_list_resolve_visible_count(state->visible_count);
    return (rt_uint8_t)((state->item_count + visible_count - 1U) / visible_count);
}

rt_uint8_t surge_ui_list_page_index(const surge_ui_list_state_t *state)
{
    rt_uint8_t visible_count;

    if ((state == RT_NULL) || (state->item_count == 0U))
    {
        return 0U;
    }

    visible_count = surge_ui_list_resolve_visible_count(state->visible_count);
    return (rt_uint8_t)((state->selected_index / visible_count) + 1U);
}
#endif
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
