realdengziqi/URGEPEAKLOGGER_AT32_-RTTHREAD/(notices)

Notices in the files:
datasheet/中景园1.3寸屏/03-程序源码/01-1.3IPS显示屏C51_SPI例程/main.c:
Copyright(C) ÖÐ¾°Ô°µç×Ó2014/3/16
All rights reserved
